GitBMP/home-fan/home-fan.kicad_pcb

## KiCad design OBD3/OBD3.kicad_sch


Parts:
C1: 10u
C2, C4, C5: 0.1u
C3: 44u
C6: 100n; C_Rect_L4.6mm_W3.0mm_P2.50mm_MKS02_FKP02
CR1: E-L9637D; SO-8_3.9x4.9mm_P1.27mm
D1: BZT52C12
D2: SMBJ24A
D3: 1N4148W; D_DO-201_P5.08mm_Vertical_AnodeUp
F1: 1A
J1: OBD In
L1: 10u
Q1: SQ2319CES-T1_GE3; PMOSGSD_SOT-23_TO-236_VIS
R1: 13.7k
R2, R3: 100k
R4: 510; R_Axial_DIN0207_L6.3mm_D2.5mm_P7.62mm_Horizontal
U1: LMR51420XDDCR; SOT23_DDC_TEX
U2: MCP2562-E-SN; SOIC-8_3.9x4.9mm_P1.27mm
U3: XIAO-ESP32-C6-SMD

Connections:
+3.3V: C4.2, CR1.3 (VCC), U2.5 (Vio)
+5V: C3.2, C5.2, L1.2, R2.2, U2.3 (VDD)
+12V: C1.2, D1.1 (K), D2.1 (K), D3.2 (A), J1.5, Q1.2 (S), R4.1, U1.3 (VIN)
CAN High: J1.3, U2.7 (CANH)
CAN Low: J1.7, U2.6 (CANL)
CAN RX: U2.4 (RXD), U3.4 (D3)
CAN TX: U2.1 (TXD), U3.3 (D2)
GND: C1.1, C3.1, C4.1, C5.1, C6.2, CR1.5 (GND), D2.2 (A), J1.1, J1.2, R1.1, R3.1, U1.1 (GND), U2.2 (VSS)
GPI02: CR1.2 (LO)
GPIO0: CR1.4 (TX)
GPIO1: CR1.1 (RX)
GPIO_FILL LATER!!!!!!!!!!!!!!!!!!!!!!!!!!!: U2.8 (STBY)
K RX: U3.2 (D1)
K TX: U3.1 (D0)
K-Line: J1.4
K_Line: CR1.6 (K), R4.2
L-Line: J1.6
L_Line: CR1.8 (LI)
unnamed: C2.1, U1.6 (CB)
unnamed: C2.2, L1.1, U1.2 (SW)
unnamed: C6.1, CR1.7 (VS), D3.1 (K)
unnamed: D1.2 (A), Q1.1 (G), R3.2
unnamed: F1.2, Q1.3 (D)
unnamed: R1.2, R2.1, U1.4 (FB)
V_Bat: F1.1

Notes on the sheet:
Maybe add CAN ESD protection PESD2CAN
CAN Transceiver
Circuit Protection
K-Line Transceiver
12V>5V Buck
