GitBMP/home-fan/(commit log)

2026-10-17 Initial commit: schematics, part libraries, README
    ESP32-C6 controller for two reversing 12 V PWM fans, replacing the
    electronics of an inVENTer iV14 ventilation system. Schematics and
    LCSC part selection done, PCB layout not started yet.
    [BlockDiagram.kicad_sch, ESP32-C6-1.kicad_sch, ESP32-C6-2.kicad_sch, home-fan.kicad_pcb, home-fan.kicad_sch]
2026-10-17 README wording, schematic tweak
    Clarify humidity sensor purpose (bathroom boost), add slider price,
    line breaks in push/pull section.
    [ESP32-C6-1.kicad_sch]
